witchof0x20/3d/10rack/hdd/references/backplane.jpg

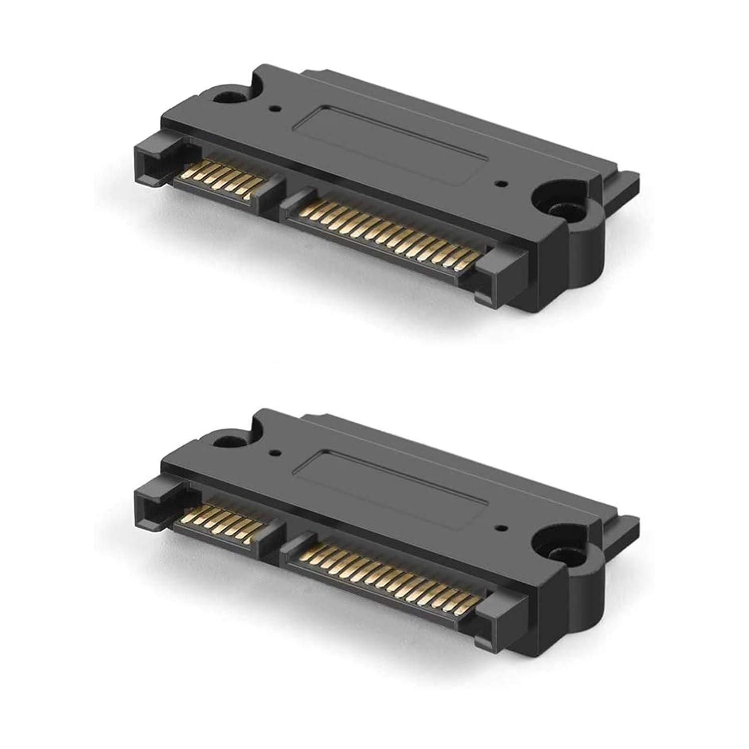
10rack/hdd/references/backplane.jpg
