witchof0x20/3d/(commit log)

2026-10-06 Add 10" rack mount for two Flex ATX PSUs
    Parametric OpenSCAD body + rear clamp plate, built to STLs via
    10rack/flexatx/default.nix and exposed as packages.flexatx.
    [flexatx_mount.scad]
2026-10-06 flexatx: bolt PSUs to the panel and rear plate via 6-32 holes
    Hole positions from Intel's Flex ATX mechanical drawing: four on the
    IEC face, two on the DC face. Adds a front pocket around the IEC inlet
    so a C13 plug body can seat, and tightens the length clearance since
    both ends are now bolted.
    [flexatx_mount.scad]
2026-10-06 flexatx: close front cutouts in 1U and tidy screw pads
    The top lip sits in front of the PSU face, so it fits in 1U; the
    cutouts are now closed frames instead of open notches. The IEC pocket
    no longer thins the whole side lip, and adjacent screw pads merge into
    one tab.
    [flexatx_mount.scad]
2026-10-06 flexatx: mount PSUs by their 1U bracket, use nut pockets
    Rework around the 1U bracket that ships with FSP FlexGURU PRO (and
    similar) PSUs: the bracket drops into a slot behind the front panel and
    is screwed through the panel's ears into M3 nuts captured in the wall
    ends. Front windows are now plain rectangles. Heat-set inserts are
    replaced by hex nut pockets, here and on the rear plate.
    Bracket defaults (100x40 mm, ears 90 mm apart) are from a generic Flex
    ATX 1U bracket listing and should be measured against the real part.
    [flexatx_mount.scad]
2026-10-08 Add 3U rack insert for eight 3.5" drives on edge
    Sized for the DeskPi RackMate T2's 212 mm opening: eight drives use the
    whole width, so there is no box. A bottom and top plate (one part,
    printed twice) bolt to the front posts and carry caddies in grooves; a
    beam behind the drives stops them, and per-drive backplane bars holding
    SATA pass-through adapters screw to it via heat-sets. A fan panel slides
    into the same grooves and ties the plates at the rear, and small rear
    braces bolt to the rear posts and slide into sockets in the plates so
    the whole insert comes out the front.
    Claude-Session: https://claude.ai/code/session_01Nnap9xSZE5rM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
    [hdd_cage.scad]
2026-10-08 hdd: remove unsupported overhangs on the fan panel and backplane bar
    The fan panel's tongues hung past the panel edge 3 mm above the bed;
    give each a tab to stand on. Chamfer the backplane bar's foot tongues on
    the side that faces the bed so they print as 45 degree slopes instead of
    4 mm ledges.
    Claude-Session: https://claude.ai/code/session_01Nnap9xSZE5rMHeWop6McJT
    [hdd_cage.scad]
2026-10-08 hdd: screw drives into one-piece caddies instead of pegs and a clip
    The caddy is now a handle with both arms; the drive slides in from the
    side and four countersunk 6-32 flat-head screws go through the arms into
    its side holes, recessed below the arm faces since the arms ride on the
    plates. Drops the separate clip part and adds 0.4 mm of clearance
    between the arms.
    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
    [hdd_cage.scad]
2026-10-08 hdd: put backplane bar screws on the slot centerline
    The plate's heat-set holes for the bars were placed from the guessed
    adapter thickness. Put them on each slot's centerline instead, so the
    plate no longer depends on the adapter and the turned-over top plate
    shares the same eight holes.
    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
    [hdd_cage.scad]
2026-10-09 hdd: ease the caddy's last bit of travel
    The handle had 0.55 mm of vertical clearance, so first-layer squish on
    its print face caught as it entered the plates. Make the handle 0.3 mm
    shorter top and bottom than the arms, chamfer its front face, and
    soften the detent bump from 0.6 to 0.45 mm.
    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
    [hdd_cage.scad]
2026-10-09 hdd: add a pan-head option for the caddy screws
    screw_head = "pan" counterbores the arms instead of countersinking
    them. Heads must still sit below the arm faces, so an assert refuses
    heads too tall to leave min_floor of plastic under them; standard 6-32
    pan heads (~2.3 mm) need low-profile button or wafer heads instead.
    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
    [hdd_cage.scad]
2026-10-09 hdd: taper the caddy tongue to match the plate grooves; default to pan heads
    The groove lead-in was a hull of the mouth and the whole groove, so the
    grooves taper from 8.5 mm at the front to 6.5 mm at the beam rather than
    flaring for 1 mm. Plates are already printed that way, and the taper is
    a reasonable guide, so make it explicit (groove_taper) and taper the
    caddy's tongue to keep tongue_clr per side along its whole length:
    loose going in, centered once seated. The detent notches now follow the
    tapered wall.
    Also default the caddy screws to (low-profile) pan heads.
    Claude-Session: https://claude.ai/code/session_01Nnap9xSZE5rMHeWop6M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
    [hdd_cage.scad]
2026-10-09 hdd: add a handle mount and a printable pull for the caddies
    Each caddy handle gets two M3 heat-set holes in its front face,
    mount_spacing apart (64 mm, a standard cabinet-pull spacing), above and
    below the finger pocket; vents that would break into them are skipped.
    The new pull part is a D-pull that screws on through counterbored posts
    and prints standing on its bar. handle_mount = false leaves the handles
    plain.
    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
    [hdd_cage.scad]
2026-10-09 hdd: print the caddy lying on its side
    Standing on the handle put the layer lines across the arm-to-handle
    joint where the arms bend, and made a tall, tippy print. Lie it on the
    side the drive's PCB faces instead: the arms extend to that face so
    they sit on the bed, and the tongues are chamfered at 45 degrees on that
    side. The detent finger cannot print that way and was not clicking in
    the tapered grooves anyway, so drop it and the plate's notches; the
    SATA connector holds the caddy in.
    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
    [hdd_cage.scad]
2026-10-09 hdd: slot the backplane bar's adapter holes so the adapter can be lined up
    On the test fit the adapter sat below the drive's connector, so its
    nominal height (from the SFF-8323 location and a guessed adapter) is
    off. Replace the ear pilot holes with vertical slots (adapter_travel,
    -3 to +4 mm, limited by the top beam) and hex tracks on the back face
    that hold M3 nuts against turning while letting them slide.
    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
    [hdd_cage.scad]
2026-10-09 hdd: center the adapter slot on the measured position, +-1 mm
    Test fitting put the adapter at the top of its -3..+4 mm travel, so
    record that as adapter_dz = 4 and narrow the slot to +-1 mm around it.
    Re-estimate adapter_len as 47 mm (40 mm hole pitch plus ear radius) so
    +1 mm still clears the top beam.
    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
    [hdd_cage.scad]
